peterzimon/stm32-midi-to-cv/README.md

# STM32 MIDI to CV converter

Polyphonic MIDI to CV converter using STM32F103 (blue pill)
