peterzimon/stm32-midi-to-cv/schematics/Plots/MidiPoly.pdf

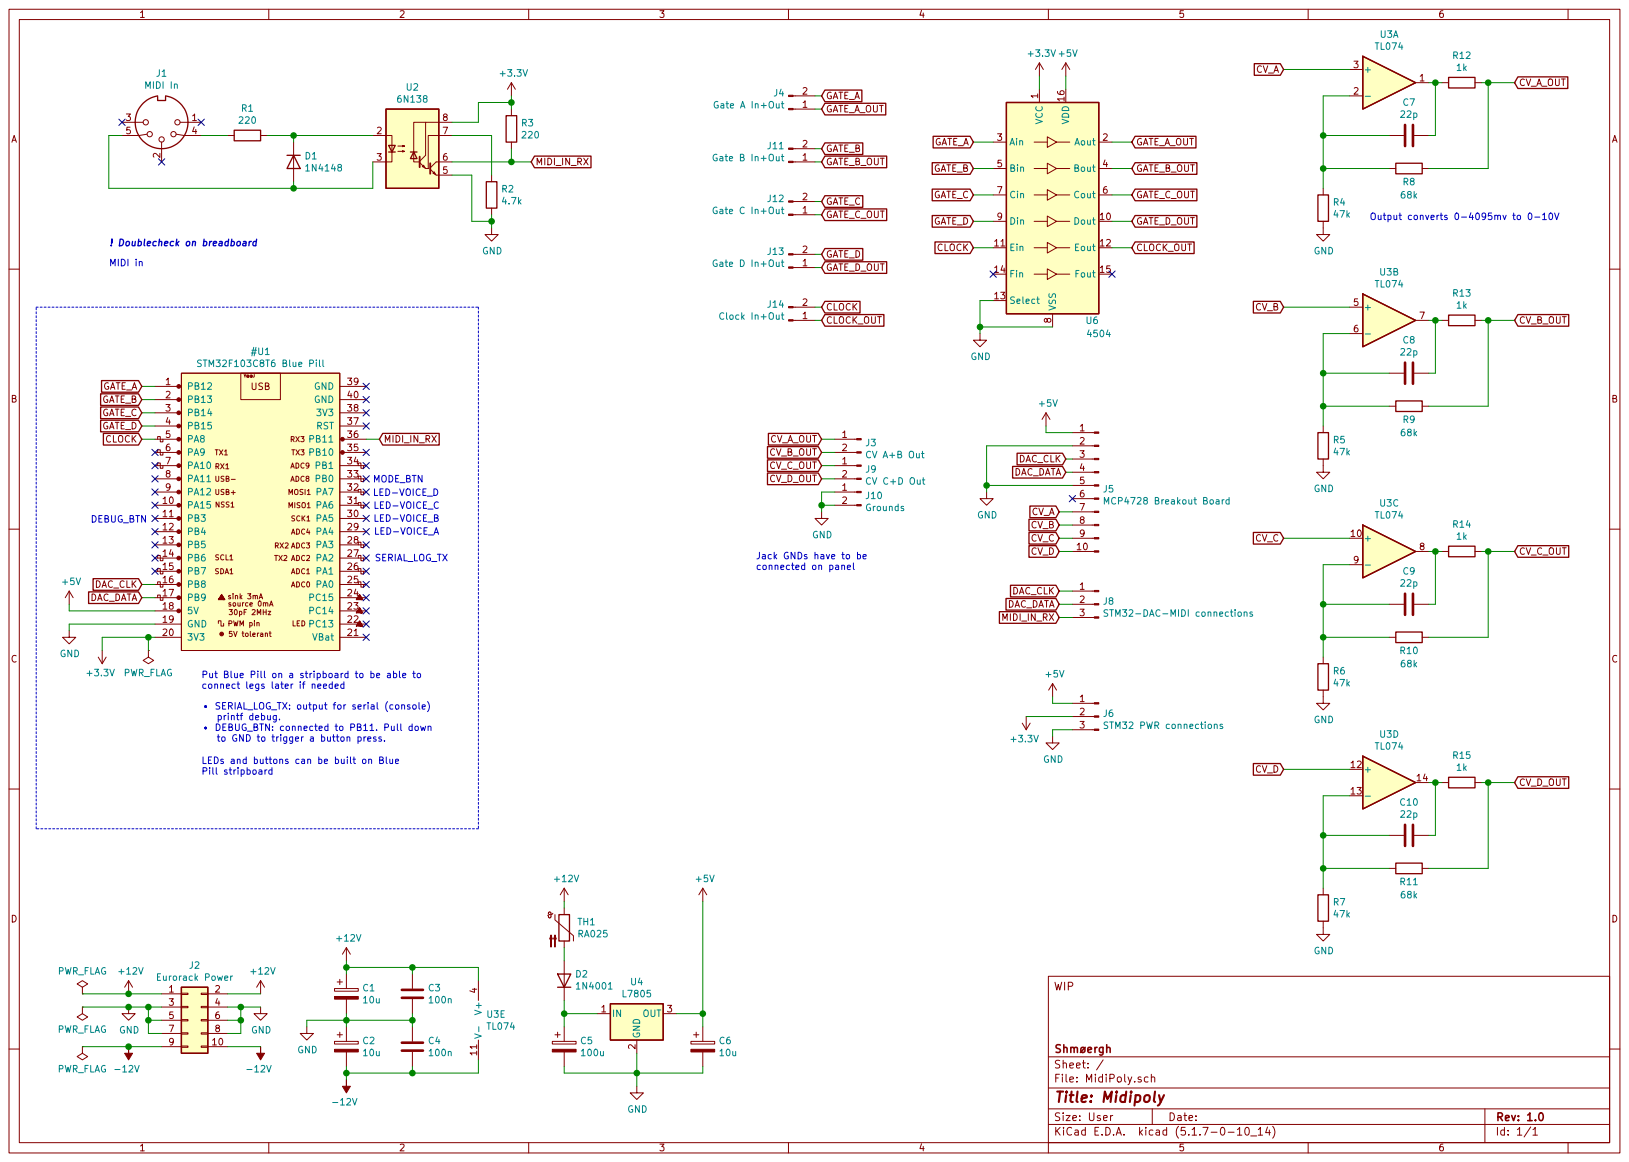
[picture p1: page 1]

1 Dout 10 Ein 11 Eout 12 Select 13 Fin 14 Fout 15 VDD 16 Aout 2 Ain 3 Bout 4 Bin 5 Cout 6 Cin 7 VSS

Jack GNDs have to be connected on panel

Put Blue Pill on a stripboard to be able to
connect legs later if needed
SERIAL_LOG_TX: output for serial (console)
printf debug.
DEBUG_BTN: connected to PB11. Pull down
to GND to trigger a button press.

LEDs and buttons can be built on Blue Pill stripboard

File: MidiPoly.sch Sheet: / Shmøergh WIP
