peterzimon/stm32-midi-to-cv/schematics/Plots/MidiPoly-B_Cu.pdf

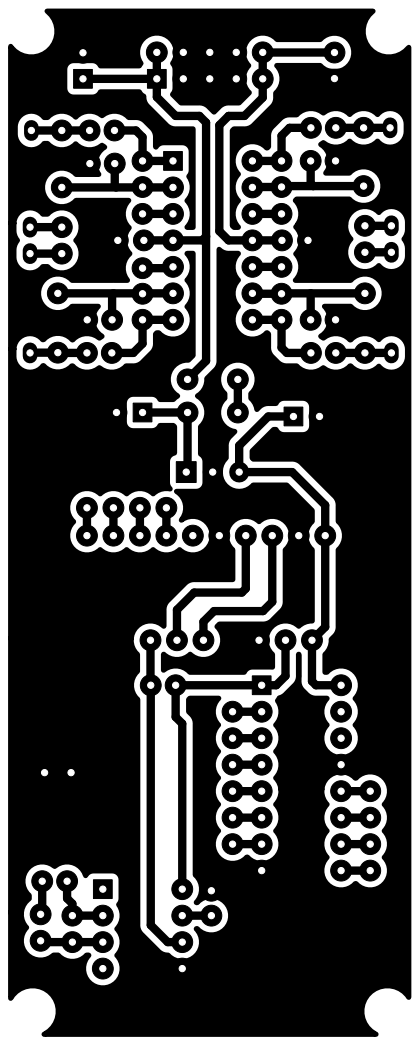
[picture p2: page 1]
