peterzimon/stm32-midi-to-cv/schematics/Plots/MidiPoly-F_Cu.pdf

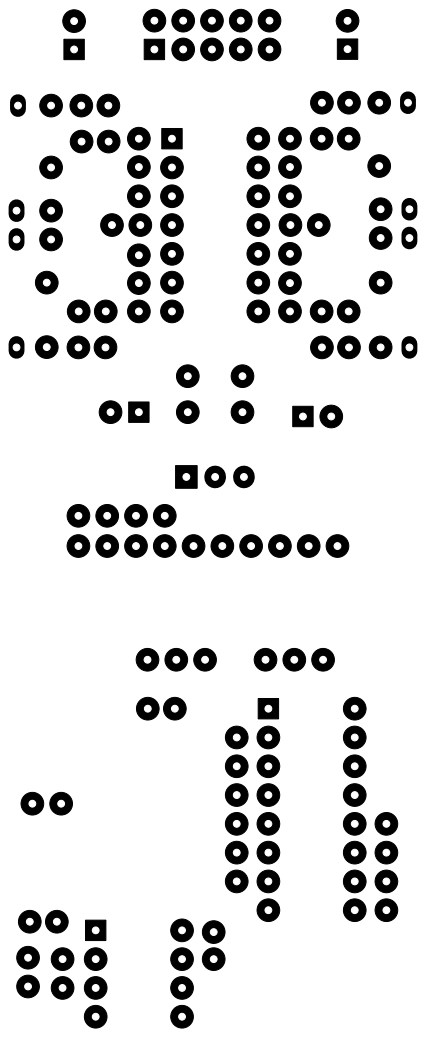
[picture p3: page 1]
