peterzimon/stm32-midi-to-cv/schematics/Plots/MidiPoly-F_Fab.pdf

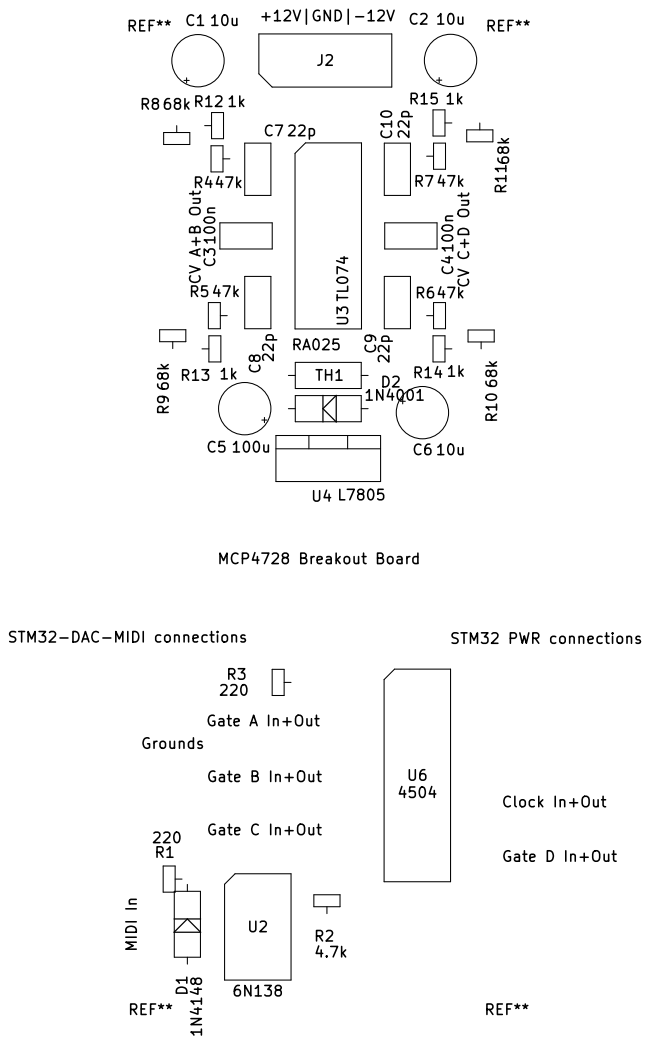
[picture p4: page 1]
