peterzimon/stm32-midi-to-cv/schematics/Plots/MidiPoly-Margin.pdf

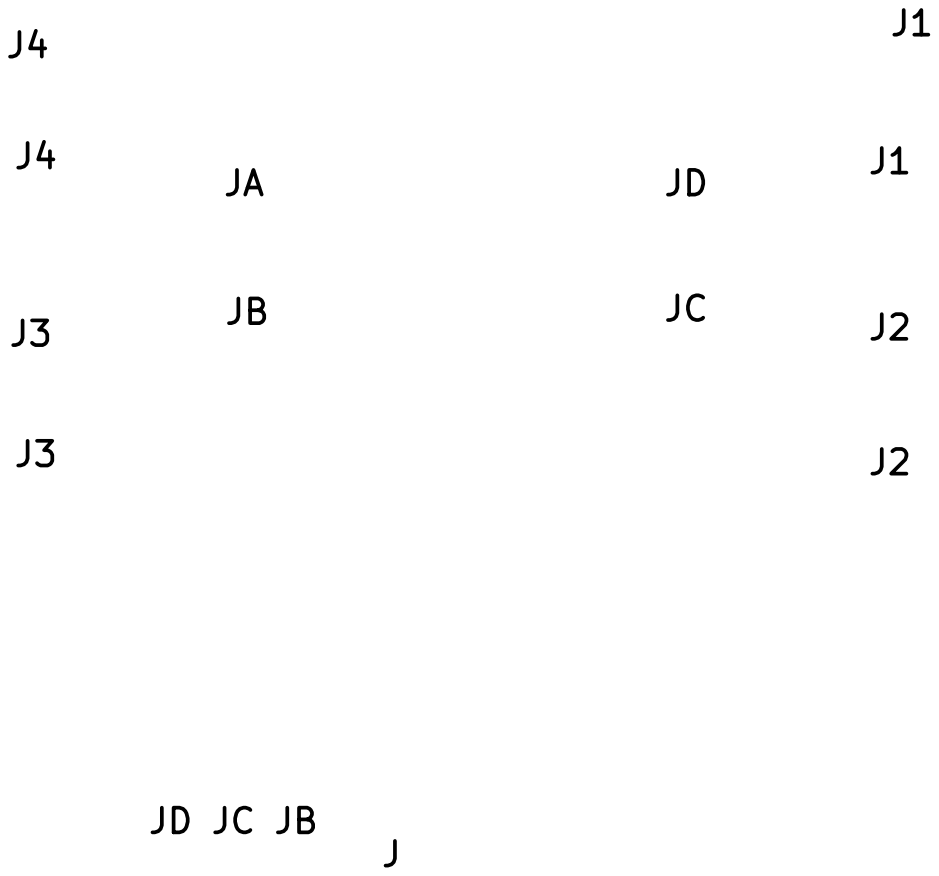
[picture p5: page 1]
