peterzimon/stm32-midi-to-cv/schematics/MidiPoly.kicad_pcb

## KiCad design schematics/MidiPoly.kicad_pcb (2022-10-25)

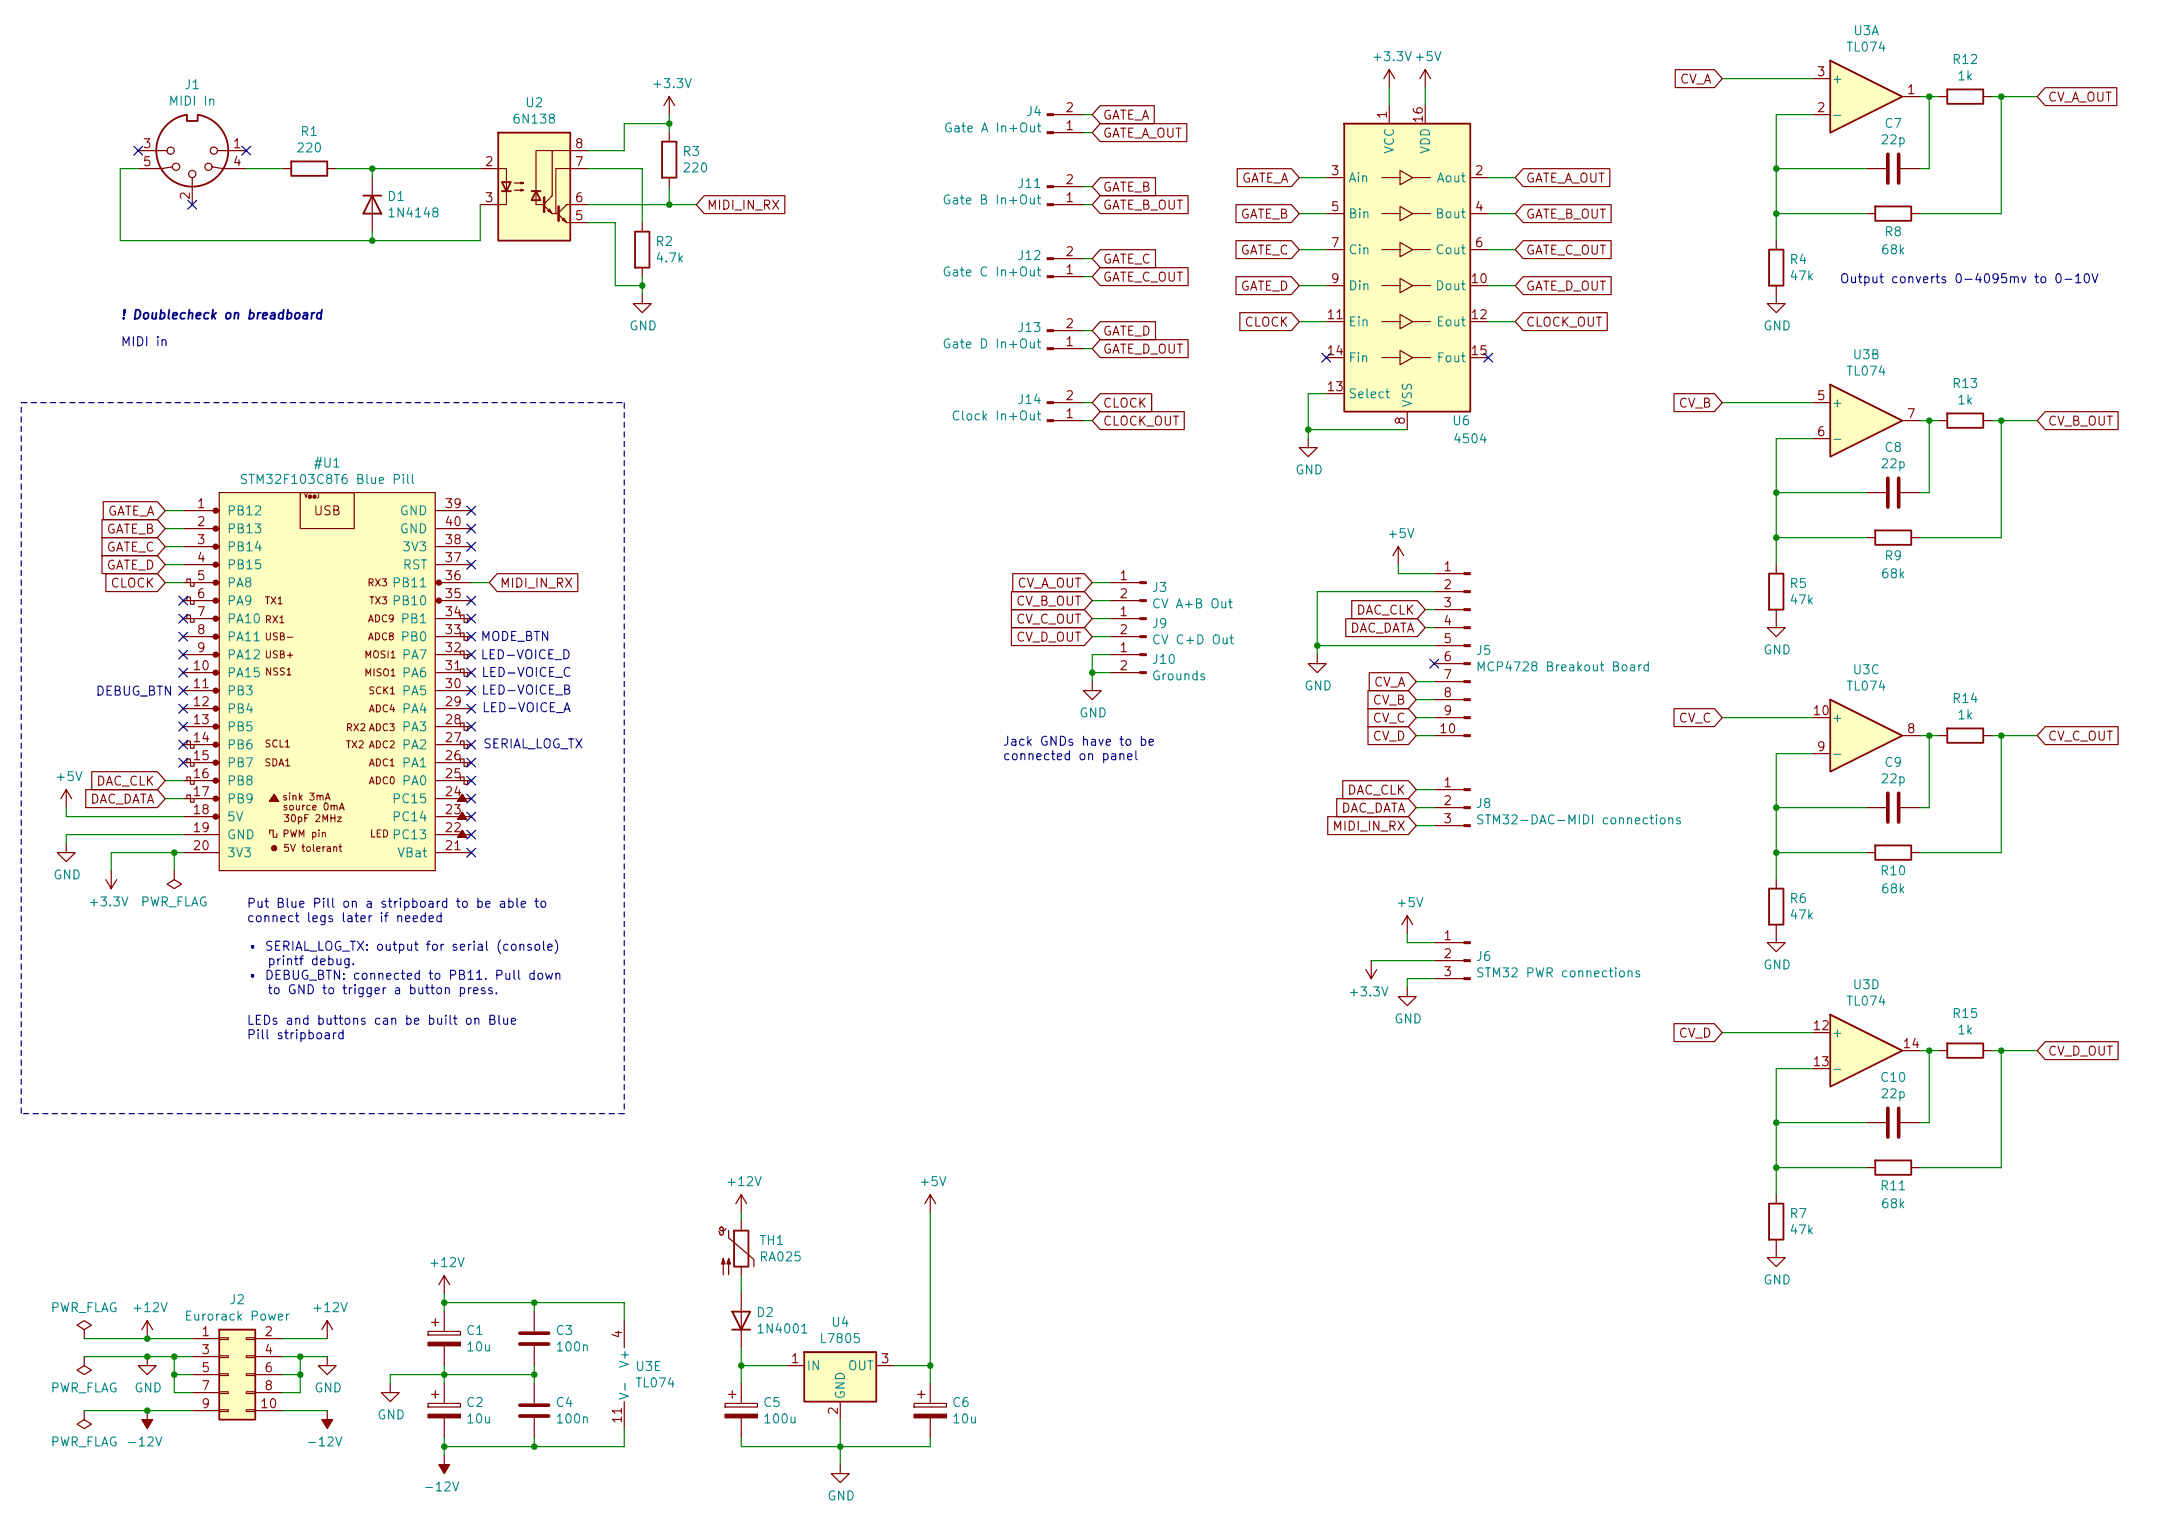
[picture p6: schematic MidiPoly.sch]

Parts:
C1, C2, C6: 10u; CP_Radial_D5.0mm_P2.50mm
C3, C4: 100n; C_Disc_D5.0mm_W2.5mm_P2.50mm
C5: 100u; CP_Radial_D5.0mm_P2.50mm
C7, C8, C9, C10: 22p; C_Disc_D5.0mm_W2.5mm_P2.50mm
D1: 1N4148; D_Axial
D2: 1N4001; D_Axial
J1: MIDI In; MIDI_Input
J2: Eurorack Power; Eurorack_Power_Supply
J3: CV A+B Out; PinOut_01x02
J4: Gate A In+Out; PinOut_01x02
J5: MCP4728 Breakout Board; PinOut_01x10
J6: STM32 PWR connections; PinOut_01x03
J8: STM32-DAC-MIDI connections; PinOut_01x03
J9: CV C+D Out; PinOut_01x02
J10: Grounds; PinOut_01x02
J11: Gate B In+Out; PinOut_01x02
J12: Gate C In+Out; PinOut_01x02
J13: Gate D In+Out; PinOut_01x02
J14: Clock In+Out; PinOut_01x02
R1, R3: 220; R_Axial_Vertical
R2: 4.7k; R_Axial_Vertical
R4, R5, R6, R7: 47k; R_Axial_Vertical
R8, R9, R10, R11: 68k; R_Axial_Vertical
R12, R13, R14, R15: 1k; R_Axial_Vertical
TH1: RA025; R_Axial_DIN0207_L6.3mm_D2.5mm_P7.62mm_Horizontal
U2: 6N138; DIP-8_W7.62mm
U3: TL074; DIP-14_W7.62mm
U4: L7805; TO-220-3_Vertical
U6: 4504; DIP-16_W7.62mm

Connections:
+12V: C1.1, C3.1, J2.1, J2.2, TH1.1, U3.4 (V+)
-12V: C2.2, C4.2, J2.9, J2.10, U3.11 (V-)
CLOCK_OUT: J14.1, U6.12 (Eout)
CV_A: J5.7, U3.3 (+)
CV_A_OUT: J3.1, R8.1, R12.1
CV_B: J5.8, U3.5 (+)
CV_B_OUT: J3.2, R9.1, R13.1
CV_C: J5.9, U3.10 (+)
CV_C_OUT: J9.1, R10.1, R14.1
CV_D: J5.10, U3.12 (+)
CV_D_OUT: J9.2, R11.1, R15.1
GATE_A_OUT: J4.1, U6.2 (Aout)
GATE_B_OUT: J11.1, U6.4 (Bout)
GATE_C_OUT: J12.1, U6.6 (Cout)
GATE_D_OUT: J13.1, U6.10 (Dout)
unnamed: C5.1, D2.1 (K), U4.1 (IN)
unnamed: C7.1, R12.2, U3.1
unnamed: C7.2, R4.1, R8.2, U3.2 (-)
unnamed: C8.1, R13.2, U3.7
unnamed: C8.2, R5.1, R9.2, U3.6 (-)
unnamed: C9.1, R14.2, U3.8
unnamed: C9.2, R6.1, R10.2, U3.9 (-)
unnamed: C10.1, R15.2, U3.14
unnamed: C10.2, R7.1, R11.2, U3.13 (-)
unnamed: D1.1 (K), R1.1, U2.2 (C1)
unnamed: D1.2 (A), J1.5, U2.3 (C2)
unnamed: D2.2 (A), TH1.2
unnamed: J1.4, R1.2
unnamed: R2.1, U2.7 (VO1)

Notes on the sheet:
MIDI in
! Doublecheck on breadboard
Output converts 0-4095mv to 0-10V
• SERIAL_LOG_TX: output for serial (console) printf debug. • DEBUG_BTN: connected to PB11. Pull down to GND to trigger a button press.
Put Blue Pill on a stripboard to be able to connect legs later if needed
SERIAL_LOG_TX
DEBUG_BTN
LEDs and buttons can be built on Blue Pill stripboard
Jack GNDs have to be connected on panel
LED-VOICE_A
LED-VOICE_B
LED-VOICE_C
LED-VOICE_D
MODE_BTN

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
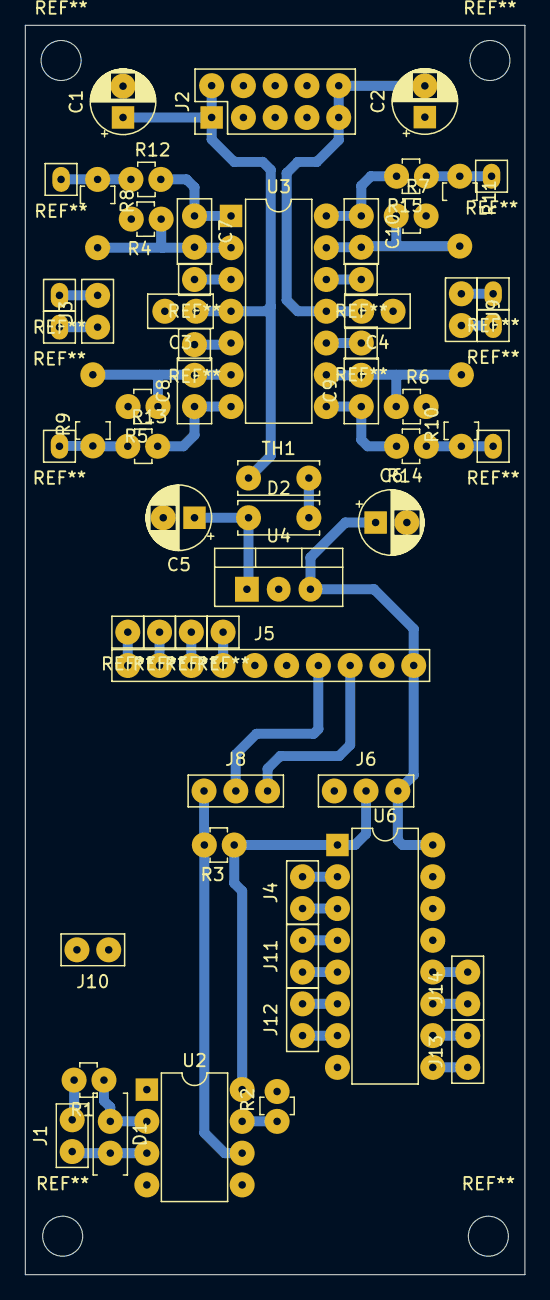
[picture p7: board MidiPoly.kicad_pcb from above]

Board: 2 copper layers, 39.9 x 99.9 mm, 45 parts (0 on the bottom side), 40 nets.
