peterzimon/stm32-midi-to-cv/src/midi-handler.cpp

#include <stdio.h>
#include <math.h>
#include "midi-handler.h"

void MidiHandler::init(void) {
    _inputBuffer.init(_buffer, MIDI_BUFFER_SIZE);

    for (int i = 0; i < VOICES; i++) {
        _cvs[i] = 0;
        _gates[i] = 0;
    }
}

void MidiHandler::setMode(void) {
    /**
     *  The _cvGate pointer will be set to the appropriate implementation of 
     * the CVGate interface. With this, it's quite easy to add implementations
     * for new modes.
    */
    switch (settings.mode) {
        case MONO:
            _cvGate = &_mono;
            _mono.setMode(MONOMODE_DEFAULT);
            break;
        case CIRCULAR:
            _cvGate = &_mono;
            _mono.setMode(MONOMODE_CIRCULAR);
            break;
        case UNISON:
            _cvGate = &_mono;
            _mono.setMode(MONOMODE_UNISON);
            break;
        case POLY:
            _cvGate = &_poly;
            _poly.setMode(POLYMODE_DEFAULT);
            break;
        case BCH:
            _cvGate = &_poly;
            _poly.setMode(POLYMODE_BCH);
            break;
        case CHL:
            _cvGate = &_poly;
            _poly.setMode(POLYMODE_CHL);
            break;
        case QUAD:
            _cvGate = &_quad;
            break;
    }

    // Hard reset voices to avoid accidental stuck gates or CVs
    for (int i = 0; i < VOICES; i++) {
        _cvs[i] = _gates[i] = 0;
    }
    _updateOutput();
}

void MidiHandler::attach(DAC *dac) {
    _dac = dac;
}

void MidiHandler::attach(Gate *gate) {
    _gate = gate;
}

void MidiHandler::attach(UI *ui) {
    _ui = ui;
}

void MidiHandler::saveByte(uint8_t byte) {
    _inputBuffer.writeByte(byte);
}

void MidiHandler::process() {
    while (!_inputBuffer.isEmpty()) {
        uint8_t byte = 0;
        _inputBuffer.readByte(byte);
        this->parseByte(byte);  // Parent class call
    }
    if (settings.modeDirty) {
        setMode();
        settings.modeDirty = false;
    }
}

void MidiHandler::noteOff(uint8_t channel, uint8_t note, uint8_t velocity) {
    _cvGate->noteOff(channel, note, velocity);
    _cvGate->getCVGate(_cvs, _gates);
    _updateOutput();
}

void MidiHandler::noteOn(uint8_t channel, uint8_t note, uint8_t velocity) {
    _cvGate->noteOn(channel, note, velocity);
    _cvGate->getCVGate(_cvs, _gates);
    _updateOutput();
}

void MidiHandler::pitchBend(uint8_t channel, uint16_t bend) {
    _cvGate->updatePitchBend(bend);
    _cvGate->getCVGate(_cvs, _gates);
    _updateOutput();
}

void MidiHandler::controlChange(uint8_t channel, uint8_t data1, uint8_t data2) {
    if (settings.mode != UNISON) { // ATM only these modes implement modwheel. TODO: test performance if this condition is removed
        return;
    }

    switch (data1)
    {
    case 0x01: // Mod wheel
        _cvGate->modWheel(channel, data2);
        _cvGate->getCVGate(_cvs, _gates);
        _updateOutput();
        break;
    }
}

void MidiHandler::_updateOutput(void) {
    _dac->write(_cvs);
    _gate->update(_gates);
    _ui->updateLeds(_gates);
}

void MidiHandler::debug(void) {
#ifdef SERIAL_DEBUG
    printf("Voice - CV\r\n");
    printf("-------------------\r\n");
    for (int i = 0; i < VOICES; i++) {
        printf("%d - %d\r\n", i, _cvs[i]);
    }

    _cvGate->debug();
#endif
}
