peterzimon/stm32-midi-to-cv/(commit log)

2021-04-18 Updated velocity in mono mode
2021-04-18 Basic DAC driver (untested)
2021-04-19 A couple of things
    - moved all HAL msp callbacks to system.cpp
    - added gate handler
    - added more comments
    - general cleanup
    BTW, the thing works now!
2021-04-21 Adjusted voltage calculation to 10 octaves (0-10V)
2021-04-21 Added naive calibration
2021-04-21 Added naive calibration per channel
2021-04-25 Added proper calibration
2021-04-25 Added calibration comments
2021-04-28 Added basic LED handling
2021-04-28 Updated leds
2021-04-29 Added LED lightshow and mode change
2021-05-03 Added reset on mode change
    [cvgate.h, midi-handler.cpp, mono.cpp, mono.h, poly.cpp, poly.h, quad.cpp, quad.h]
2021-05-04 Fixed pitch bend bug
    [cvgate.cpp, cvgate.h, main.cpp, midi-handler.cpp, midi-handler.h]
2021-05-04 Fixed hard reset bug when mode changed
    [main.cpp, midi-handler.cpp]
2022-10-25 Added schematics
    [MidiPoly.kicad_pcb, MidiPoly.sch]
